tomcircuit/hd6309sbc/Hardware/PCB Data/pcbendview.jpg

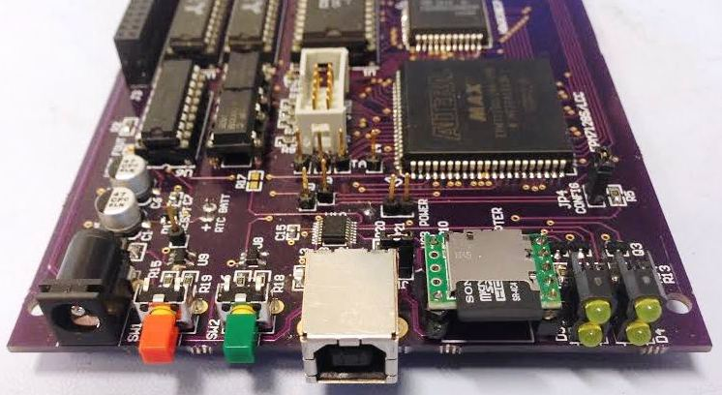
Hardware/PCB Data/pcbendview.jpg
