tomcircuit/hd6309sbc/Hardware/PCB Data/pcbtopview.jpg

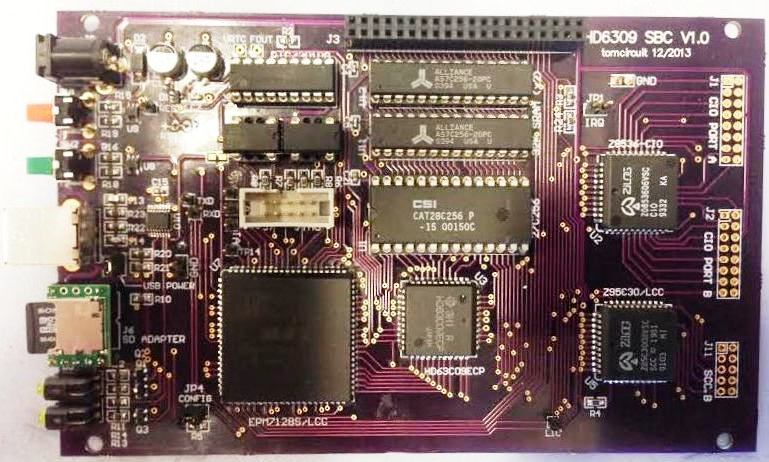
Hardware/PCB Data/pcbtopview.jpg
