tomcircuit/hd6309sbc/(list of files, cad)

Other CAD files:
Hardware/CPLD_1v3/simulation/modelsim/work/hd6309_glue_tb/behavior.psm
Hardware/CPLD_1v3/simulation/modelsim/work/hd6309_glue_top/structure.psm
