tomcircuit/hd6309sbc/Hardware/RTC_Replacement/NewRTC_installation_picture.png

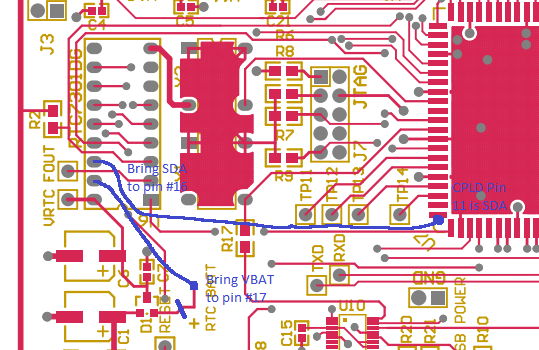
Hardware/RTC_Replacement/NewRTC_installation_picture.png
