tomcircuit/hd6309sbc/Hardware/Schematic/mezz_shifter_sch.pdf

# MEZZANINE CONNECTOR

Similar pinout as SRAM | DE1 EXPANSION CONNECTOR

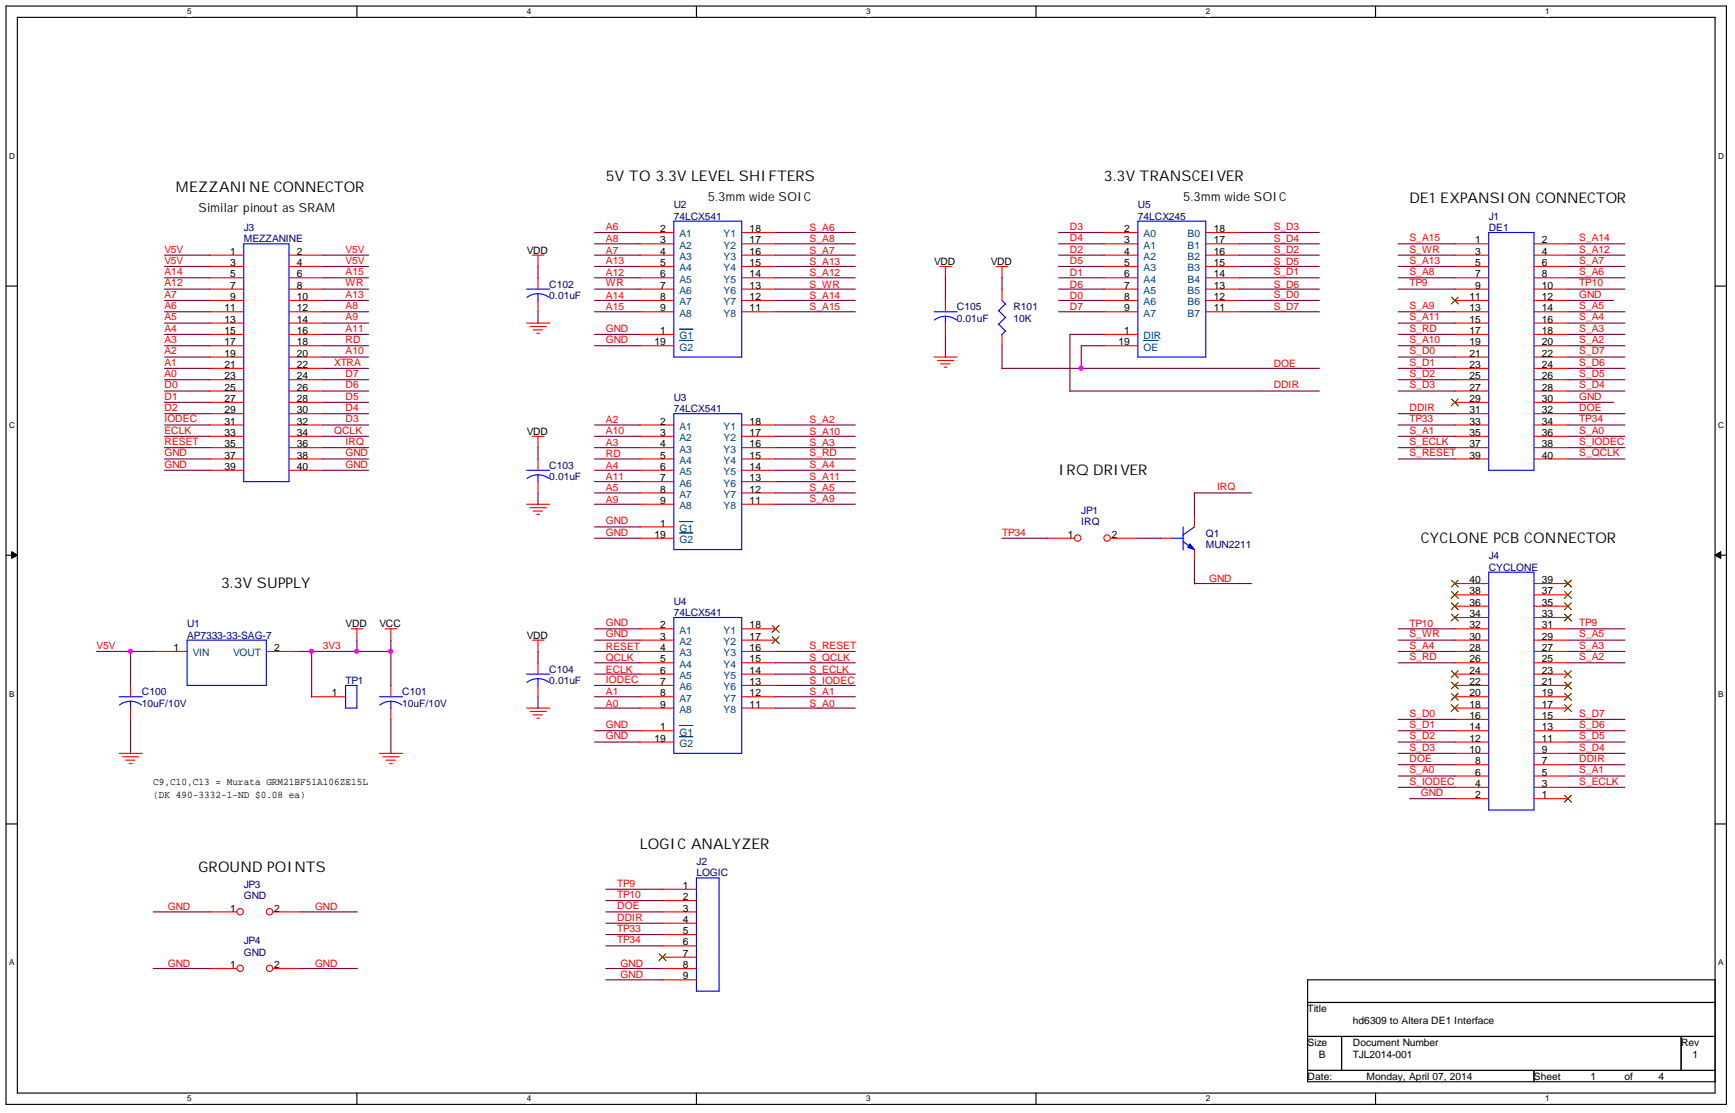
[picture p15: page 1]

Size B | Document Number TJL2014-001 | Rev 1

Date: Monday, April 07, 2014 | Sheet 1 of 4
