tomcircuit/hd6309sbc/Hardware/PCB Data/CAM for 6309mz_shift/mz_shift_pcb.pdf

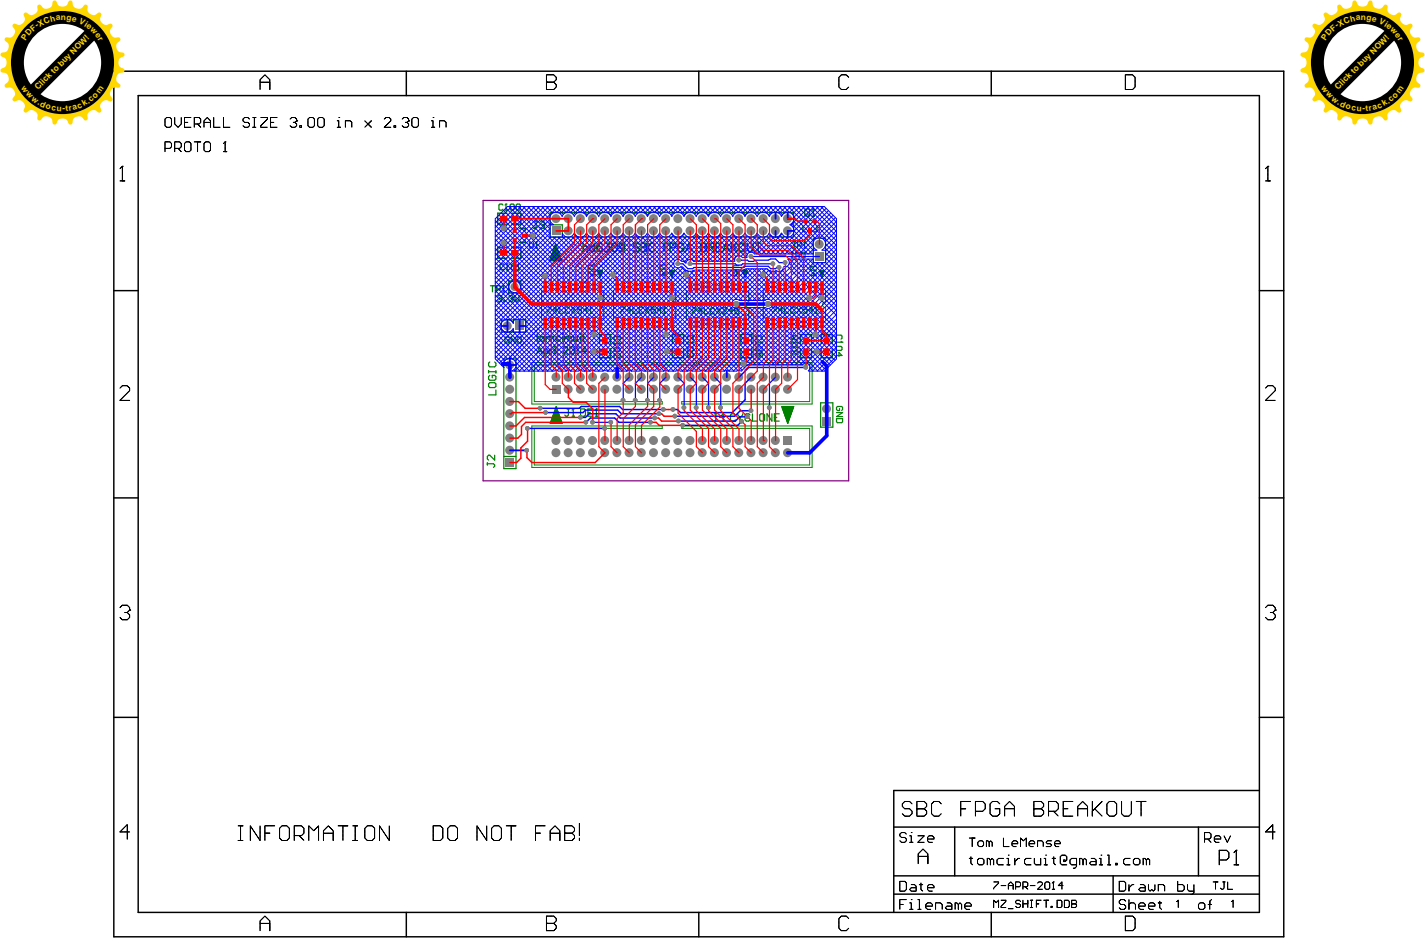
[picture p16: page 1]

PDF-XChange Viewer

Click to buy NOW!

www.docu-track.co m

www.docu-track.co m (http://www.pdfxviewer.com/)

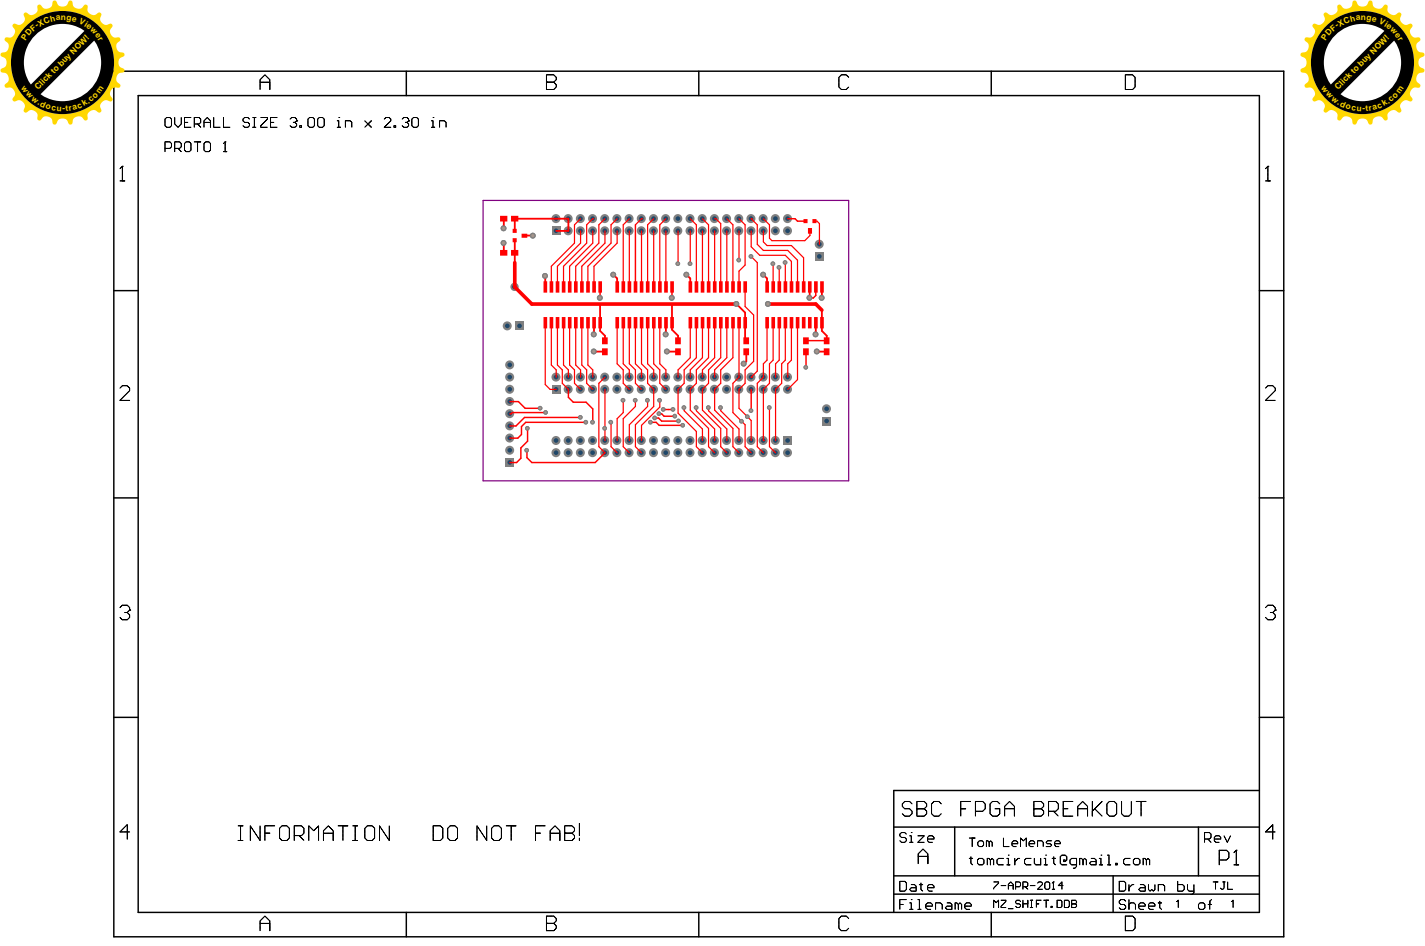
[picture p17: page 2]

Click to buy NOW!

www.docu-track.co m

www.docu-track.co m (http://www.pdfxviewer.com/)

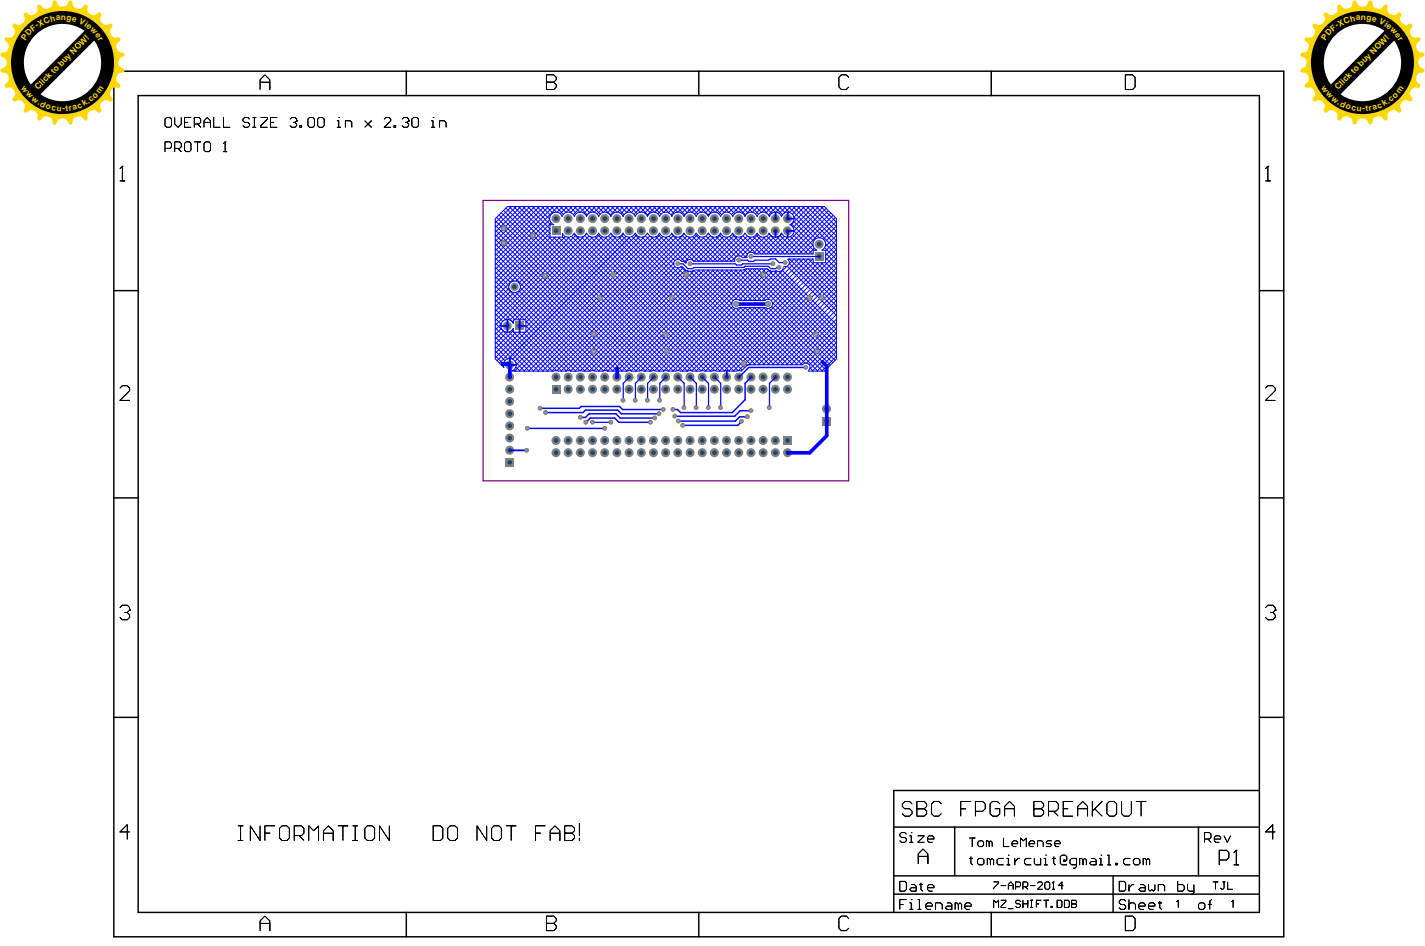
[picture p18: page 3]

Click to buy NOW!

www.docu-track.co m

www.docu-track.co m (http://www.pdfxviewer.com/)

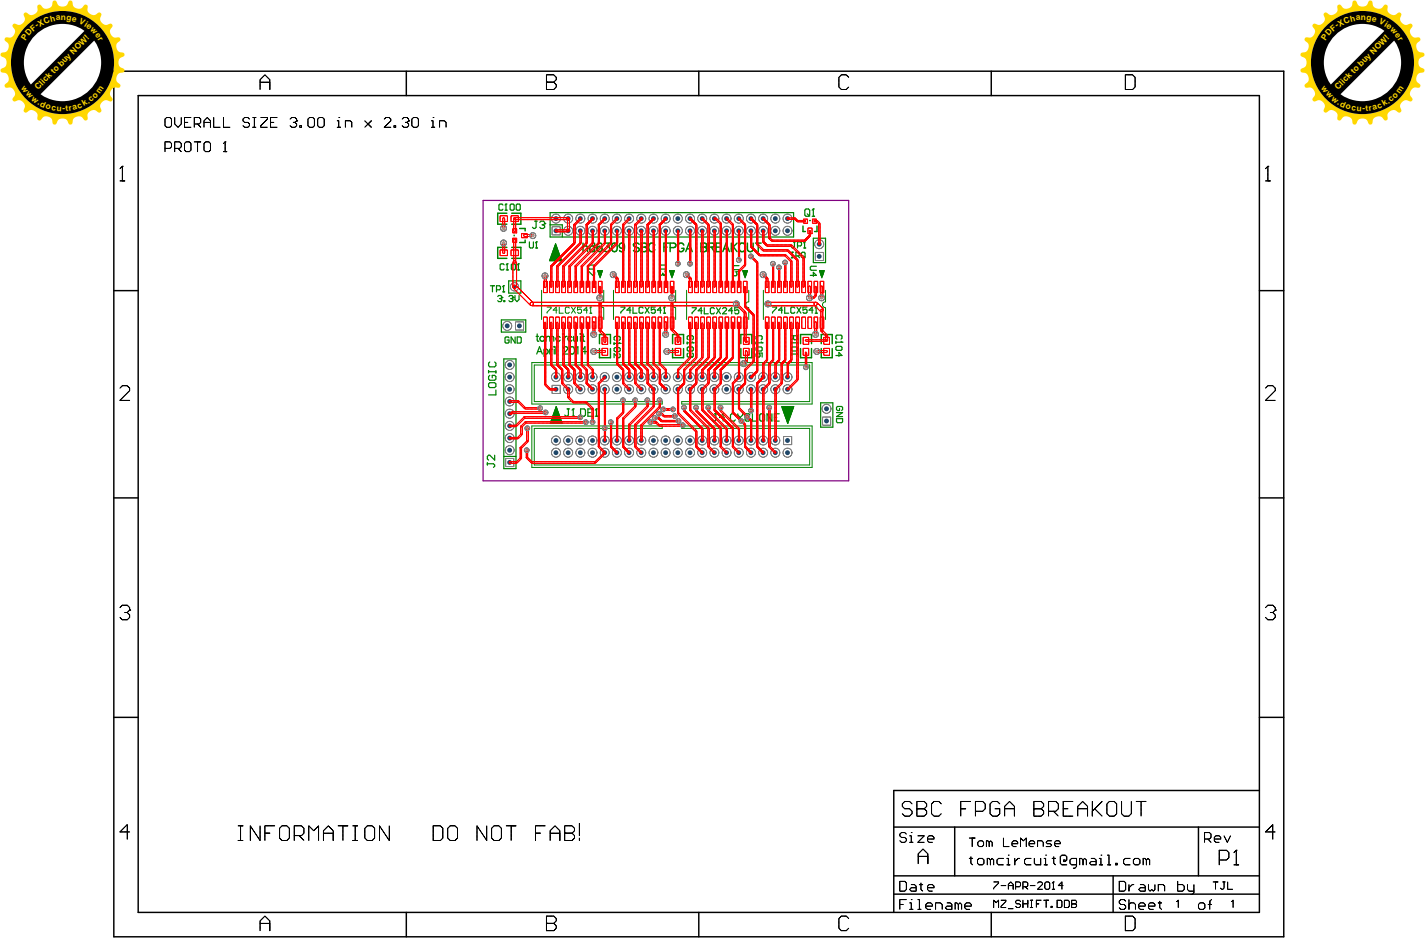
[picture p19: page 4]

Click to buy NOW!

www.docu-track.co m

www.docu-track.co m (http://www.pdfxviewer.com/)
