tomcircuit/hd6309sbc/Hardware/RTC_Replacement/NewRTC_PCB_composite.pdf

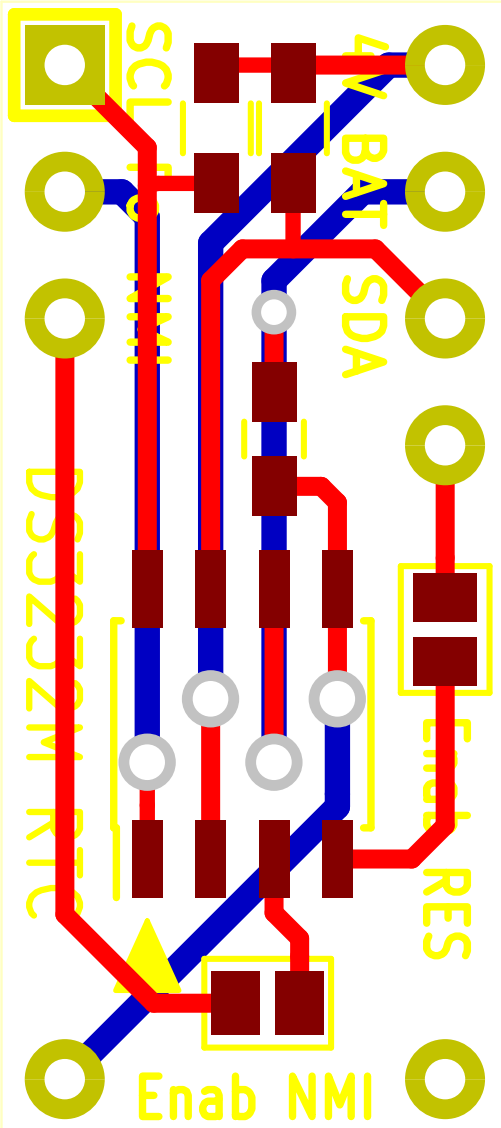
[picture p20: page 1]
