tomcircuit/hd6309sbc/Hardware/RTC_Replacement/NewRTC_schematic.pdf

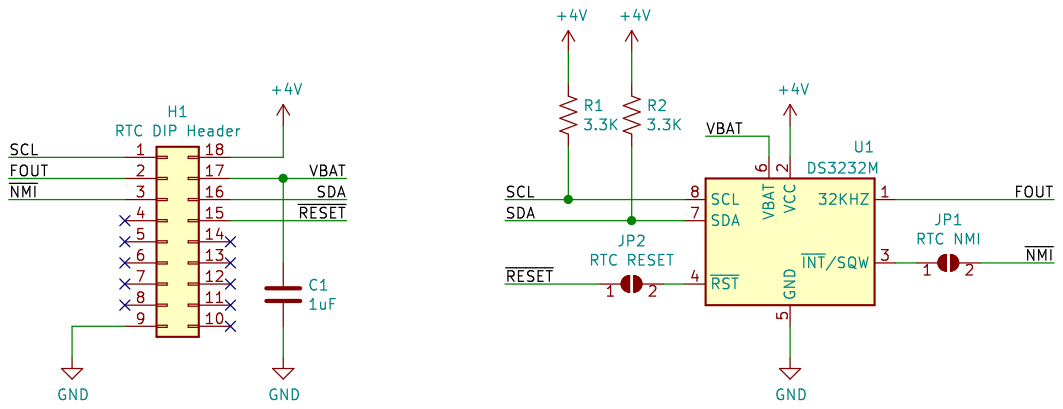
[picture p21: page 1]
