tomcircuit/hd6309sbc/Hardware/Schematic/hd6309_sbc.pdf

2489

441234

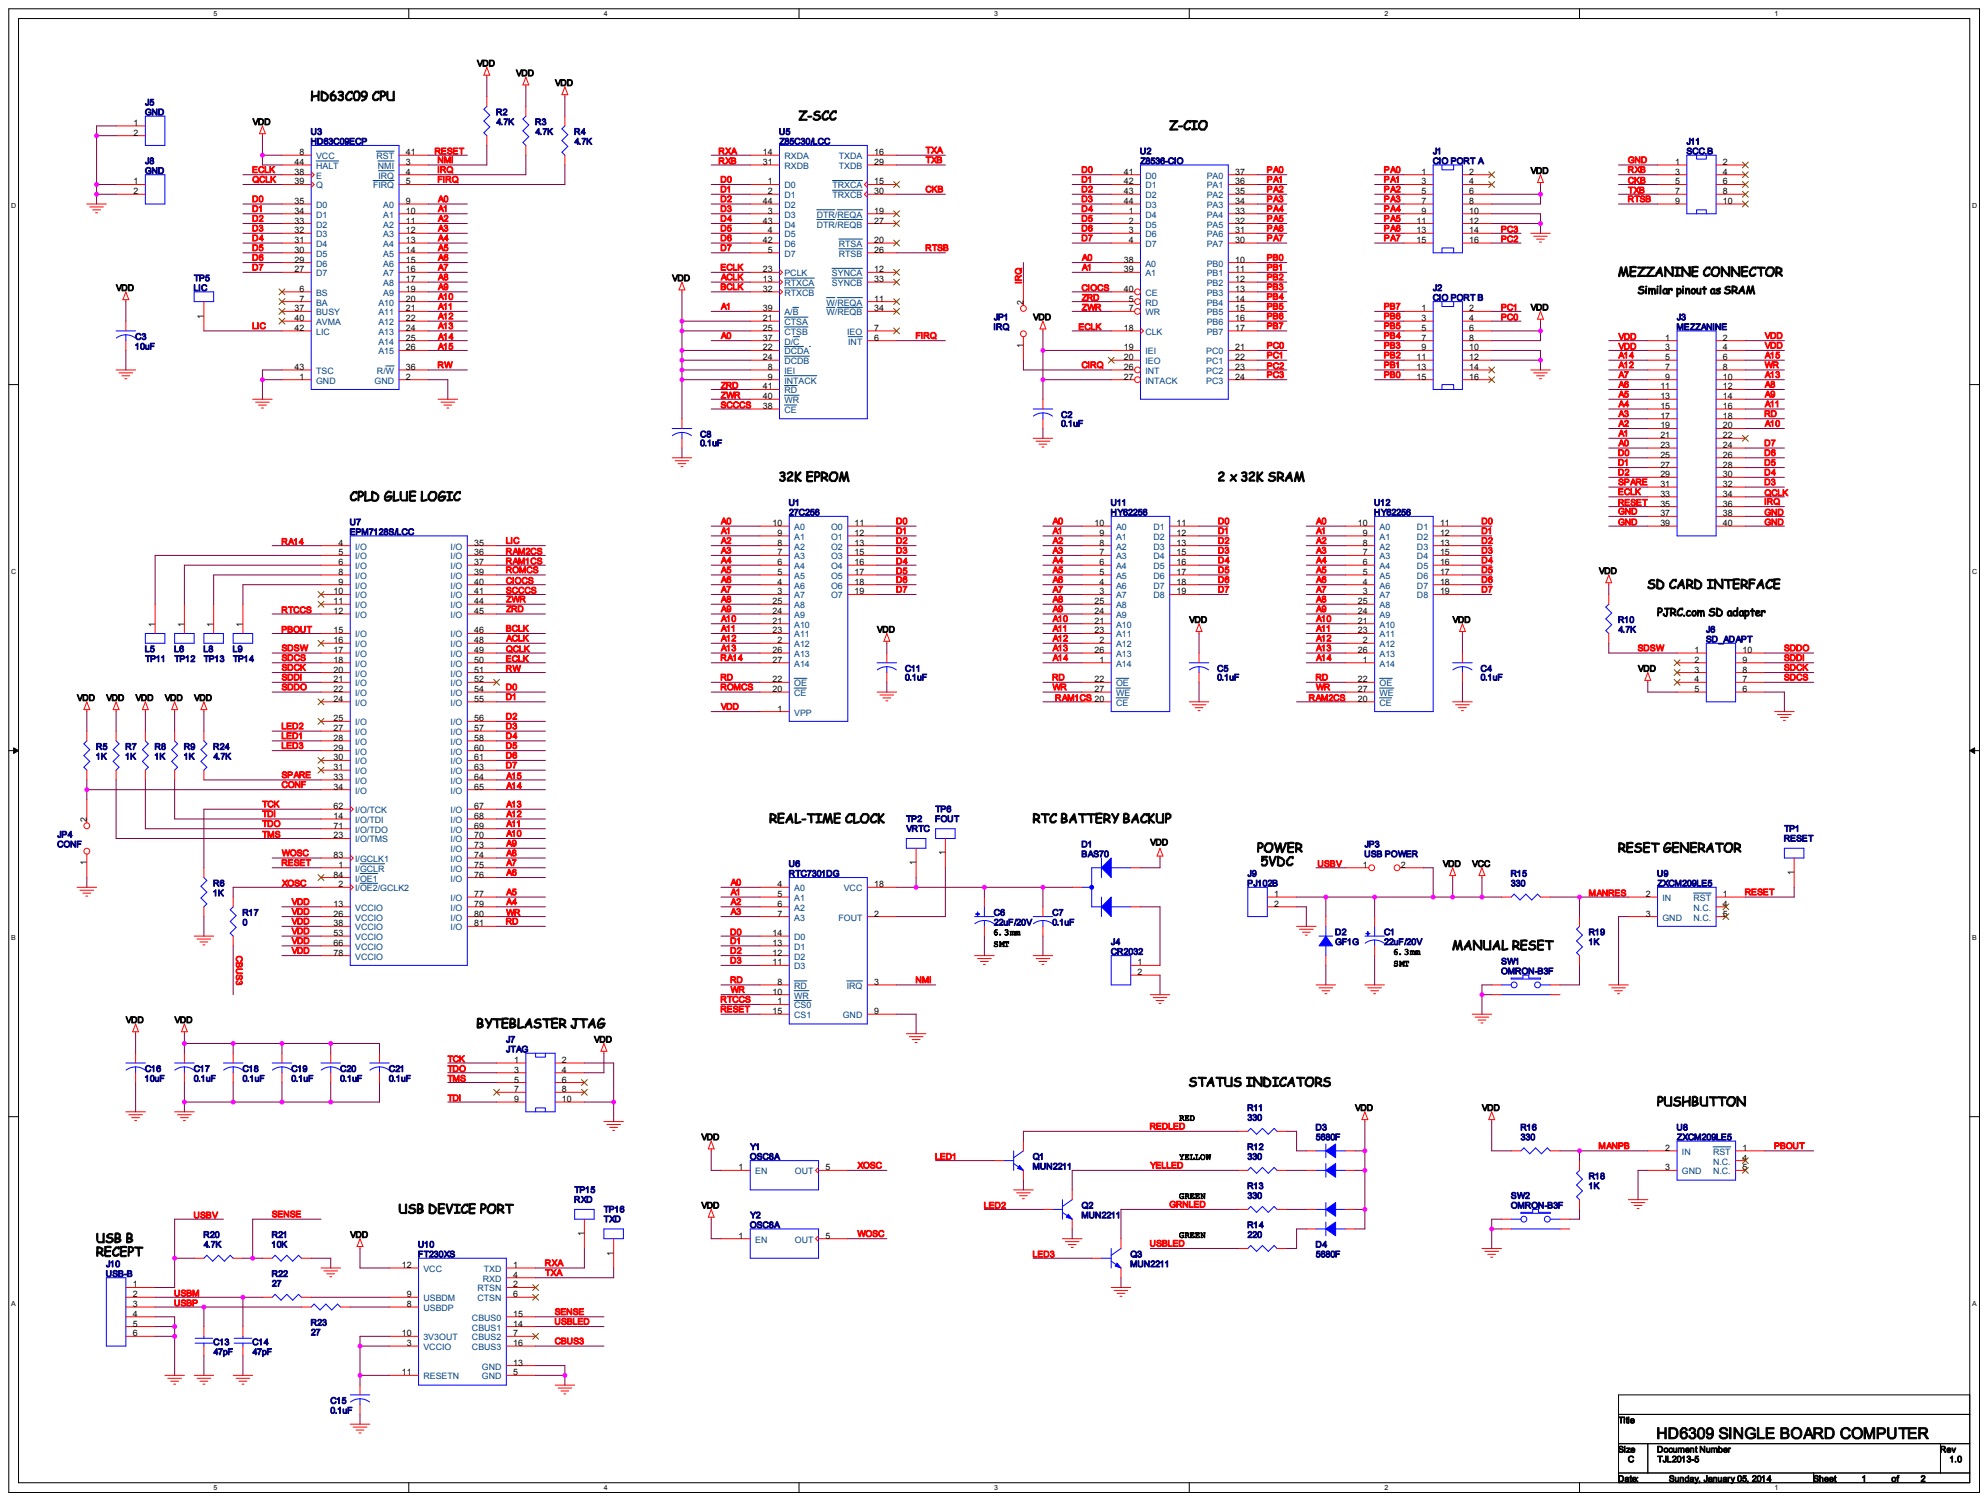
[picture p22: page 1]
