tomcircuit/hd6309sbc/(list of files, drawings)

Other design files:
Hardware/PCB Data/CAM for 6309mz_shift/6309mz_shift.pcb
Hardware/PCB Data/CAM for 6309sbc_4/6309sbc_4.pcb
Hardware/Schematic/HD6309_SBC.DSN
Hardware/Schematic/hd6309_sbc.opj
Hardware/Schematic/LIBRARY1.OLB
