tomcircuit/hd6309sbc/Hardware/RTC_Replacement/newRTC/newRTC.kicad_pcb

## KiCad design Hardware/RTC_Replacement/newRTC/newRTC.kicad_pcb (2020-01-28)

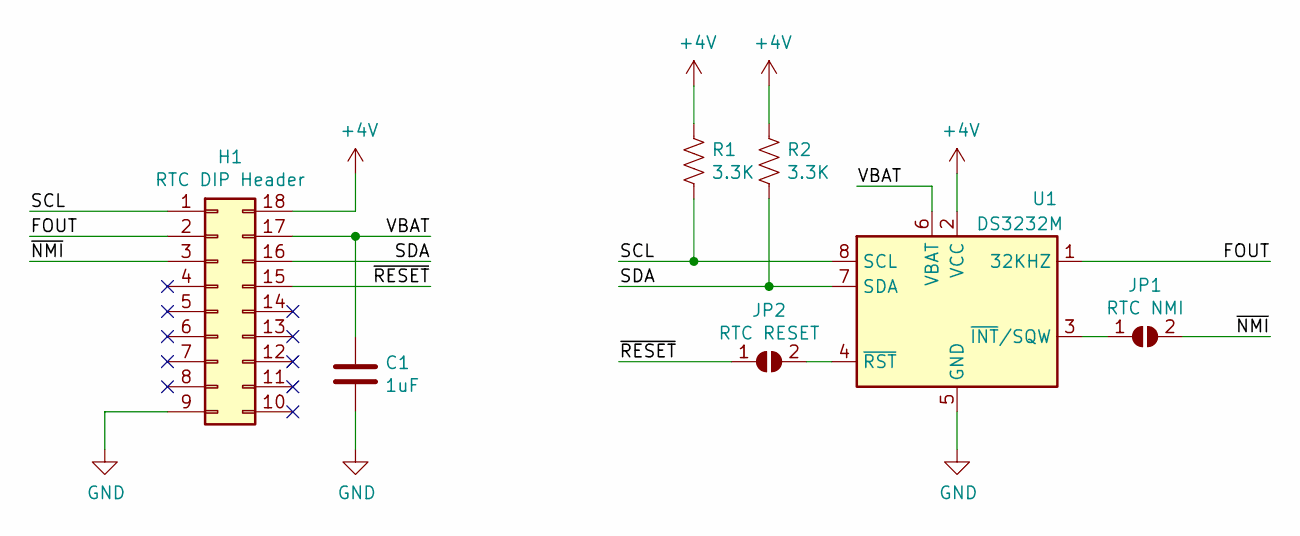
[picture p29: schematic newRTC.sch]

Parts:
C1: 1uF; C_0603_HandSoldering
H1: RTC DIP Header; RTC-DIP-Header
JP1: RTC NMI; GS2
JP2: RTC RESET; GS2
R1, R2: 3.3K; R_0603_HandSoldering
U1: DS3232M; SOIC-8_3.9x4.9mm_Pitch1.27mm

Connections:
+4V: H1.18, R1.1, R2.1, U1.2 (VCC)
/FOUT: H1.2, U1.1 (32KHZ)
/SCL: H1.1, R1.2, U1.8 (SCL)
/SDA: H1.16, R2.2, U1.7 (SDA)
/VBAT: C1.1, H1.17, U1.6 (VBAT)
/~NMI: H1.3, JP1.2 (B)
/~RESET: H1.15, JP2.1 (A)
GND: C1.2, H1.9, U1.5 (GND)
unnamed: JP1.1 (A), U1.3 (~INT~/SQW)
unnamed: JP2.2 (B), U1.4 (~RST)

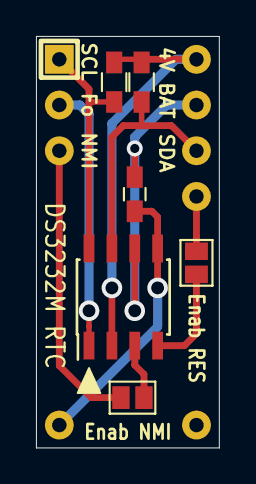
[picture p30: board newRTC.kicad_pcb from above]

Board: 2 copper layers, 10.2 x 22.9 mm, 7 parts (0 on the bottom side), 10 nets.
