tomcircuit/hd6309sbc/(commit log)

2014-03-13 Initial commit
    Hardware folders; CPLD, PCB, Schematic. Software folder; Test
    [6309sbc_4.pcb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]
2014-03-22 CPLD version 1.2
    Moved IOPAGE from $02xx to $C0xx
    Reordering of SYSCONF and INOUTP control bits
    Renamed SDPORT to SDDATA
    New SDDATA update mechanism (SR FF)
    Corrected SPI bit shift order (MSB shifts first)
    Implemented two SPI clock rates (6 MHz; 460kHz)
    Removed TP11..14 muxes (CPLD space limitations)
    Assigned TP11..14 to SDCARD SPI pins (easier debugging)
    [behavior.psm]
2014-03-22 SDtest update; Montest addition
    SDtest adapted for new IOPAGE value, changes to hardware SPI port with
    CPLD version 1.2
    Montest is a short test of the banked RAM feature; moves the monitor to
    high RAM, turns off ROMSEL
    [montest.asm, sdtest.asm]
2014-03-23 sorted out SDcard test program
    SD init and restart issue solved. WARNING: test program trashes the last
    byte of LBA block 00123456.
    [sdtest.asm]
2014-05-01 SCC channel B UART test
    Test to send characters via SCC channels A and B
2014-05-01 Added FPGA mezzanine card PCB and SCH
    PCB gerber and database for the FPGA mezzanine shifter card (5V to 3.3V)
    for use with Altera DE1 FPGA eval board in developing the VGA+Audio+PS/2
    FPGA extension.
    [6309mz_shift.pcb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]
2014-05-25 CPLD Version 1.3
    Move IO to $E000-$E1FF, add version register, split ROM around the IO
    page, ROM "writethru" into RAM, two ROM selects (ROMSEL and ROMSEH).
    [behavior.psm]
2020-01-28 CPLD 1.3 cleanup / CPLD 1.4
    cleanup CPLD 1.3 files, include CPLD output files, add CPLD 1.4 files, update readme.txt throughout.
    [behavior.psm, structure.psm]
2020-01-28 Added RTC7301 replacement board
    KiCAD project and output files for RTC7301DG replacement board
    [newRTC.kicad_pcb, newRTC.sch]
2020-01-29 Monitor / RTC for V1.4 CPLD
    in-process files for I2C and adaption to V1.4 CPLD for Monitor
2020-01-31 grinding away at I2C driver
2020-02-17 Update MON309_1V4.ASM
    still grinding away at soft I2C functions
2020-02-18 Update MON309_1V4.ASM
    implemented all I2C functions.
    Untested.
    Need to add "I2C_Initialize" which toggles SCL untl SDA goes high, per the DS3232 datasheet
2020-03-26 updated SPI and SD code
    reconciled SD code vs. Elm-Chan code.
    ready for build and test
